mkschreder/TPS54360-power-supply/bom-list.ods

Sheet: Sheet1
 | Manufacturer SKU | Name | Package
Diode
 | B560C-13-F | B560C 60V 5A | SMC
Resistors
 | ERJ-3EKF1022V | 10k2 1% | 0603
 | AC0603FR-0713KL | 13k 1% | 0603
 | RC0603FR-07523KL | 523k 1% | 0603
 | CRCW060366K5FKEA | 66.5k 1% | 0603
 | CRCW060353K6FKEA | 53.6k 1% | 0603
 | CRCW060318K0FKEA | 18k 1% | 0603
 | CR0603-FX-1433ELF | 143k 1% | 0603
Capacitors
 | VJ0603Y682MXQPW1BC | 6.8nF 10V X7R | 0603
 | VJ0603A390KXJPW1BC | 39pF 16V C0G | 0603
 | GRM32ER71J106KA12L | 10uF 63V X7R | 1210
 | HMK107BJ104KA-T | 0.1uF 100V X5R | 0603
 | C0603X5R1C104M030BC | 0.1uF 16V X5R | 0603
 | EMK325BJ476MM-T | 47uF 16V X5R | 1210
 | VJ0603A180KXQCW1BC | 18pF 10V | 0603
 | C0603C130K8HACTU | 13pF 10V | 0603
 | VJ0603Y822KXAPW1BC | 8200pF 50V | 0603
Inductor
 | SRP6540-8R2M | 8.2uH 4.5A | 6540
 | SRR1260A-150M | 15uH 4.6A | 5050

Sheet: Design
48v in, 6v out 3.5A design
Maximum skip frequency | 1039269 | Vin = 48V
Maximum shift frequency | 1126436
Chosen switch frequency | 960 | Rt = 100k
Minimum inductor value | 5.23uH
Chosen inductor | 8.2uH
Inductor ripple current | 0.67A
Inductor maximum current | 3.835
Input ripple current | 1.59A
Input ripple voltage | 207mV
Pole frequency | 1593Hz
Zero frequency | 1092kHz
Fco switching frequency | 27.65kHz
R4 resistor | 18k
48V in, 12V out 3.5A design
Maximum skip frequency | 1880229
Maximum shift frequency | 1081618
Chosen switch frequency | 960kHz | Rt = 100k
Minimum inductor value | 9.1uH
Chosen inductor | 15uH
Inductor ripple current | 0.63
Inductor maximum current | 3.81
Input ripple current
Input ripple voltage
Pole frequency | 796
Zero frequency
Fco switching frequency
R4 resistor
