mkschreder/TPS54360-power-supply/schematic/drone-power-supply-v2.kicad_pcb

## KiCad design schematic/drone-power-supply-v2.kicad_pcb (2018-04-04)

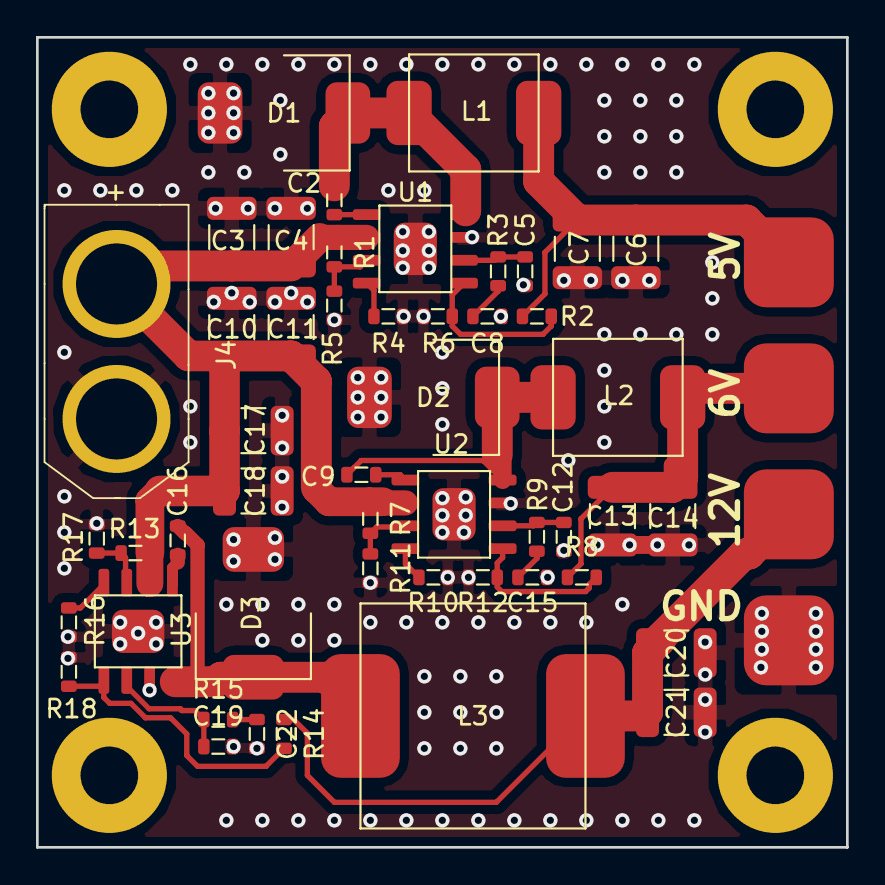
[picture p1: board drone-power-supply-v2.kicad_pcb from above]

Board: 2 copper layers, 45.0 x 45.0 mm, 57 parts (0 on the bottom side), 26 nets.

Parts:
C2, C9, C16: CAP_100nF_10V; CAPC1608X09N
C3, C4, C10, C11, C17, C18: CAP_10uF_63V; CAPC3225X25N
C5, C12, C19: CAP_39pF_16V; CAPC1608X09N
C6, C7, C13, C14, C20, C21: CAP_47uF_16V; CAPC3225X25N
C8, C15, C22: CAP_8200pF_10V; CAPC1608X09N
D1, D2, D3: D_B520C; DIOM7162X25N
J1, J2, J3, J5: POWER_PAD; PCB_WirePad_5mm
J4: CONN_XT60; XT60
L1, L2: L_8.2uH_4.5A; INDM7265X40N
L3: L_15uH_5A; INDM125125X60N
MT1, MT2, MT3, MT4: MOUNT_HOLE; MountingHole_3.2mm_M3_Pad
R1, R7, R13: RES_523K_1%; RESC1608X04N
R2: RES_53.6K_1%; RESC1608X04N
R3: RES_13K_1%; RESC1608X04N
R4: RES_162K_1%; RESC1608X04N
R5, R11, R17: RES_84.5K_1%; RESC1608X04N
R6, R12, R18: RES_10.2K_1%; RESC1608X04N
R8: RES_66.5K_1%; RESC1608X04N
R9: RES_18K_1%; RESC1608X04N
R10, R16: RES_100K_1%; RESC1608X04N
R14: RES_143K_1%; RESC1608X04N
R15: RES_25.5K_1%; RESC1608X04N
U1, U2, U3: TPS54360DDA; SOIC127P600X175_HS-9N

Connections:
/PWR_5V_SW: C2.2, D1.1, L1.1, U1.8
/PWR_6V_SW: C9.2, D2.1, L2.1, U2.8
/PWR_12V_SW: C16.2, D3.1, L3.1, U3.8
/PWR_OUT_5V: C6.1, C7.1, J1.1, L1.2, R2.1
/PWR_OUT_6V: C13.1, C14.1, J2.1, L2.2, R8.1
/PWR_OUT_12V: C20.1, C21.1, J3.1, L3.2, R14.1
GND: C3.2, C4.2, C5.2, C6.2, C7.2, C8.2, C10.2, C11.2, C12.2, C13.2, C14.2, C15.2, C17.2, C18.2, C19.2, C20.2, C21.2, C22.2, D1.2, D2.2, D3.2, J4.1, J5.1, R4.2, R5.2, R6.2, R10.2, R11.2, R12.2, R16.2, R17.2, R18.2, U1.7, U1.9, U2.7, U2.9, U3.7, U3.9
unnamed: C2.1, U1.1
unnamed: C5.1, R3.1, U1.6
unnamed: C8.1, R3.2
unnamed: C9.1, U2.1
unnamed: C12.1, R9.1, U2.6
unnamed: C15.1, R9.2
unnamed: C16.1, U3.1
unnamed: C19.1, R15.1, U3.6
unnamed: C22.1, R15.2
unnamed: R1.2, R5.1, U1.3
unnamed: R2.2, R6.1, U1.5
unnamed: R4.1, U1.4
unnamed: R10.1, U2.4
unnamed: R7.2, R11.1, U2.3
unnamed: R8.2, R12.1, U2.5
unnamed: R13.2, R17.1, U3.3
unnamed: R14.2, R18.1, U3.5
unnamed: R16.1, U3.4
VBAT: C3.1, C4.1, C10.1, C11.1, C17.1, C18.1, J4.2, R1.1, R7.1, R13.1, U1.2, U2.2, U3.2
