mkschreder/TPS54360-power-supply/(commit log)

2018-03-19 Add bom
    [bom-list.ods]
2018-03-19 add initial schematic for 5v regulator
    [drone-power-supply-v2.kicad_pcb, drone-power-supply-v2.sch]
2018-03-19 add initial board placement and 6 + 12v regulators
    [bom-list.ods, drone-power-supply-v2.kicad_pcb, drone-power-supply-v2.sch]
2018-04-04 push latest changes
    [drone-power-supply-v2.kicad_pcb, drone-power-supply-v2.sch]
